kmarx-kmarx-kmarx/Fluidcs-Hardware-V2/User KiCad Library/user-3dmodels/raspberry-pi-pico-r3-1/RP2040 Microcontroller, Raspberry Pi Pico-R3, Top View.PNG

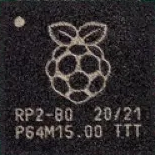
User KiCad Library/user-3dmodels/raspberry-pi-pico-r3-1/RP2040 Microcontroller, Raspberry Pi Pico-R3, Top View.PNG
