kmarx-kmarx-kmarx/Fluidcs-Hardware-V2/User KiCad Library/user-3dmodels/raspberry-pi-pico-r3-1/Raspberry Pi Pico-R3, Top View.PNG

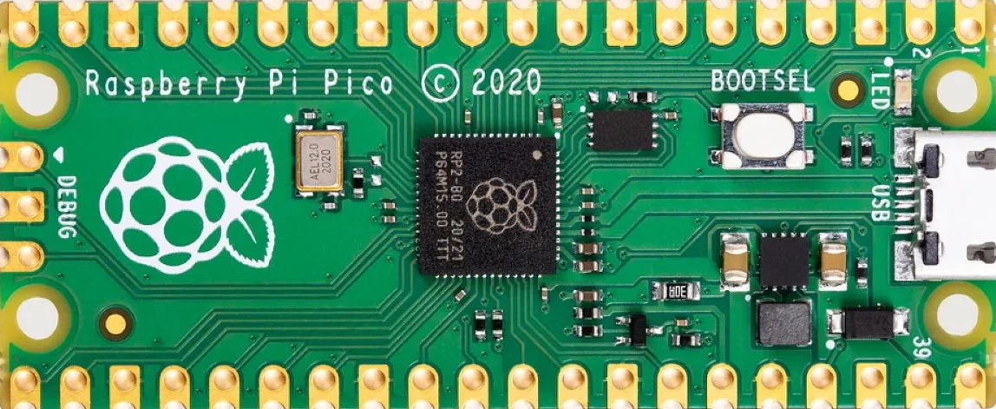
User KiCad Library/user-3dmodels/raspberry-pi-pico-r3-1/Raspberry Pi Pico-R3, Top View.PNG
