kmarx-kmarx-kmarx/Fluidcs-Hardware-V2/User KiCad Library/user-3dmodels/raspberry-pi-pico-r3-1/Raspberry Pi Pico-R3.JPG

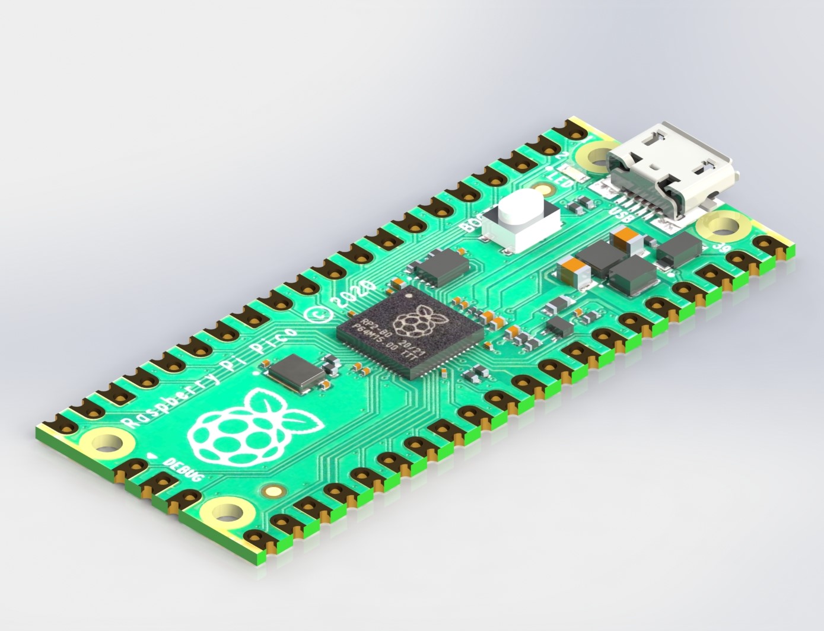
User KiCad Library/user-3dmodels/raspberry-pi-pico-r3-1/Raspberry Pi Pico-R3.JPG
