kmarx-kmarx-kmarx/Fluidcs-Hardware-V2/User KiCad Library/user-3dmodels/raspberry-pi-pico-r3-1/Raspberry Pi Pico-R3.SLDASM

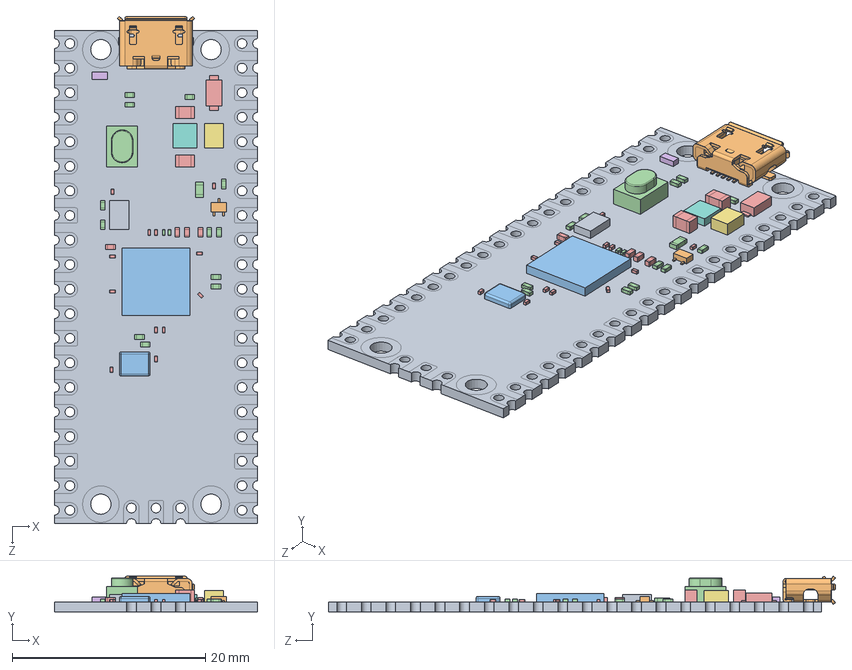
[picture p5: CAD file, 2023-08-08]
User KiCad Library/user-3dmodels/raspberry-pi-pico-r3-1/Raspberry Pi Pico-R3.SLDASM
21.0 x 3.69 x 52.4 mm
PCB, Raspberry Pi Pico-R3
MicroUSB Port, Raspberry Pi Pico-R3
RP2040 Microcontroller, Raspberry Pi Pico-R3
SW1, Tact Switch, Raspberry Pi Pico-R3
D1, Diode, Schottky, Raspberry Pi Pico-R3
D2, QSME-C194, LED, Raspberry Pi Pico-R3
L1, Inductor, Raspberry Pi Pico-R3
U2, RT6150B-33GQW, Buck Boost Converter, Raspberry Pi Pico-R3
U3, W25Q16JVUXIQ, Serial NOR Flash 16 Mbit, Raspberry Pi Pico-R3
Q1, MOSFET, DMG1012T, Raspberry Pi Pico-R3
X1, X12M000000S096, 12 Mhz Crystal Resonator, Raspberry Pi Pico-R3
SMD Resistor, Configurable, Raspberry Pi Pico-R3 x 15
SMD Capacitor, Configurable, Raspberry Pi Pico-R3 x 18
