kmarx-kmarx-kmarx/Fluidcs-Hardware-V2/User KiCad Library/user-3dmodels/Teensy_4.0_Assembly.STEP

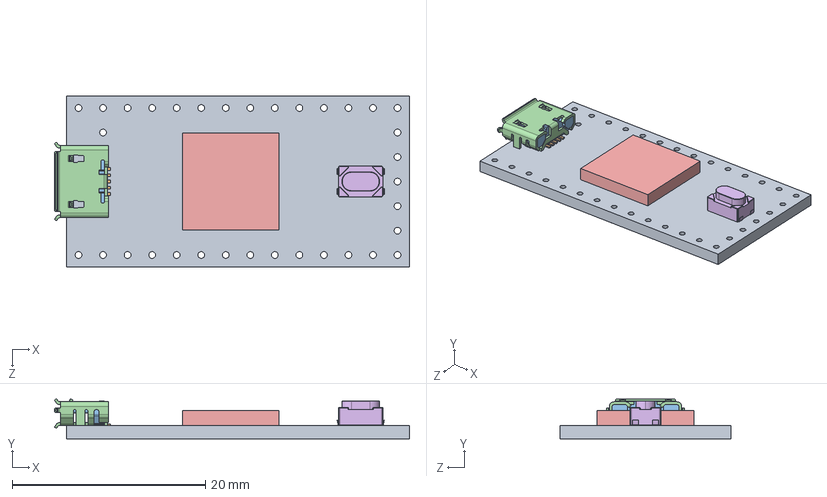
[picture p6: CAD file, 2023-08-08]
User KiCad Library/user-3dmodels/Teensy_4.0_Assembly.STEP
36.8 x 4.12 x 17.7 mm
Teensy_4.0_PCB
Micro USB-B Female 5Pin SMD
NXP iMXRT1062
SKRPACE010 v4
