kmarx-kmarx-kmarx/Fluidcs-Hardware-V2/User KiCad Library/user-3dmodels/B6B-ZR-SM4-TF.step

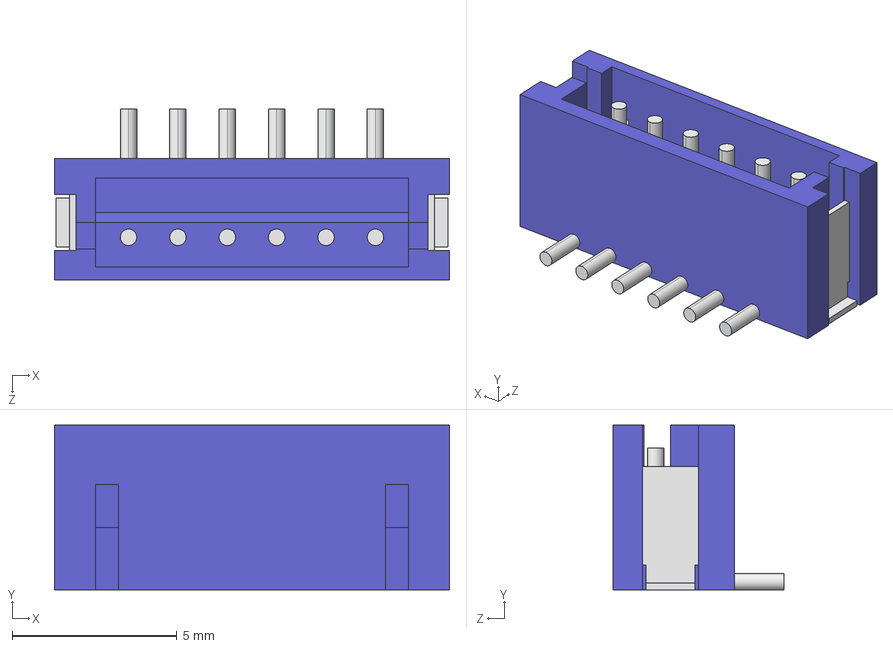
[picture p7: CAD file, 2023-08-08]
User KiCad Library/user-3dmodels/B6B-ZR-SM4-TF.step
12.0 x 5.00 x 5.20 mm
