kmarx-kmarx-kmarx/Fluidcs-Hardware-V2/User KiCad Library/user-3dmodels/raspberry-pi-pico-r3-1/RP2040 Microcontroller, Raspberry Pi Pico-R3.SLDPRT

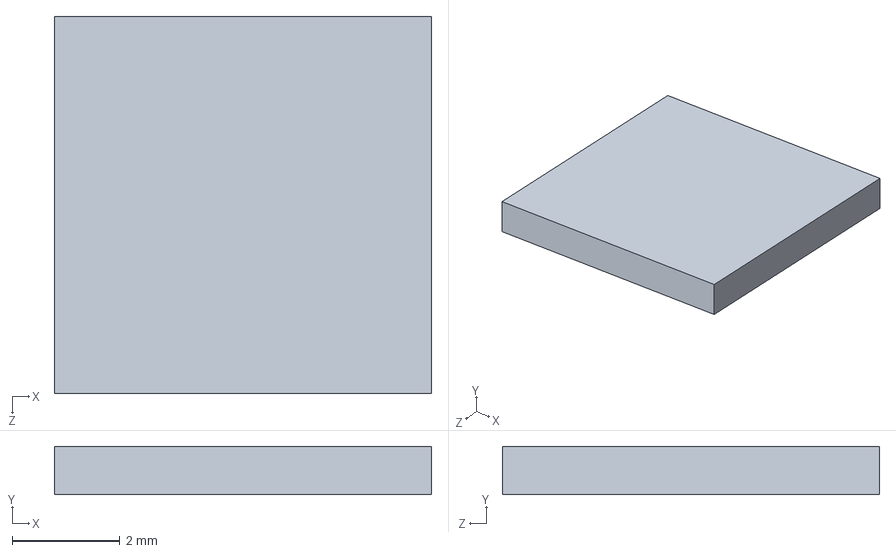
[picture p8: CAD file, 2023-08-08]
User KiCad Library/user-3dmodels/raspberry-pi-pico-r3-1/RP2040 Microcontroller, Raspberry Pi Pico-R3.SLDPRT
7.00 x 0.9 x 7.00 mm
