kmarx-kmarx-kmarx/Fluidcs-Hardware-V2/User KiCad Library/user-3dmodels/PTV09A-4020U-B103.stp

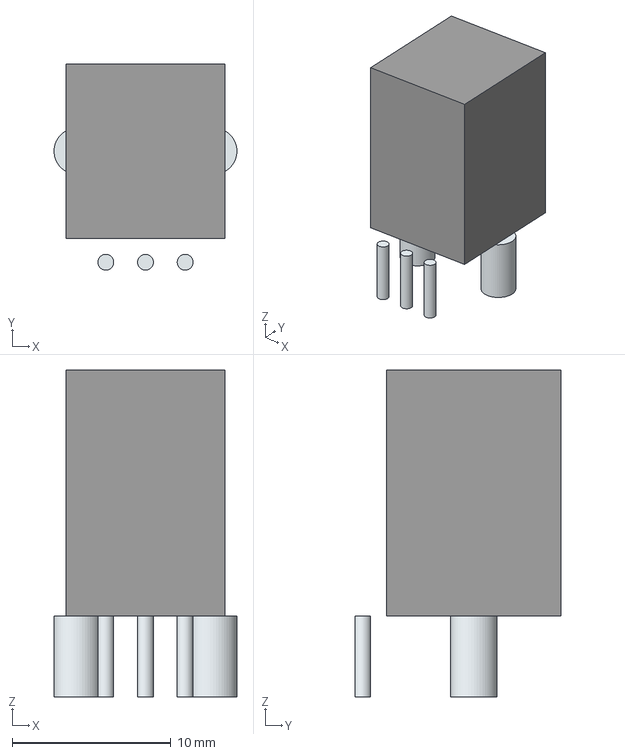
[picture p9: CAD file, 2023-08-08]
User KiCad Library/user-3dmodels/PTV09A-4020U-B103.stp
11.5 x 13.0 x 20.6 mm
Leads x 5
