kmarx-kmarx-kmarx/Fluidcs-Hardware-V2/User KiCad Library/user-3dmodels/raspberry-pi-pico-r3-1/SMD Capacitor, Configurable, Raspberry Pi Pico-R3.SLDPRT

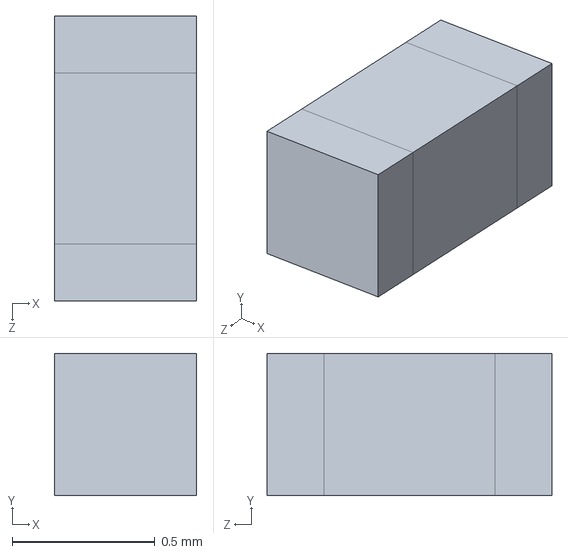
[picture p10: CAD file, 2023-08-08]
User KiCad Library/user-3dmodels/raspberry-pi-pico-r3-1/SMD Capacitor, Configurable, Raspberry Pi Pico-R3.SLDPRT
0.5 x 0.5 x 1.00 mm
