kmarx-kmarx-kmarx/Fluidcs-Hardware-V2/User KiCad Library/user-3dmodels/PCA9615DPJ.stp

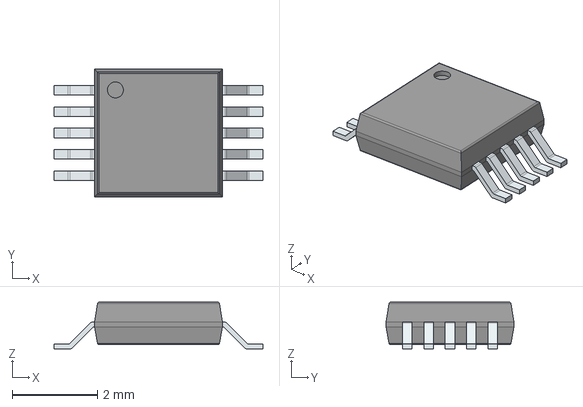
[picture p11: CAD file, 2023-08-08]
User KiCad Library/user-3dmodels/PCA9615DPJ.stp
4.90 x 3.00 x 1.10 mm
PinsArrayLR
