kmarx-kmarx-kmarx/Fluidcs-Hardware-V2/User KiCad Library/user-3dmodels/raspberry-pi-pico-r3-1/D1, Diode, Schottky, Raspberry Pi Pico-R3.SLDPRT

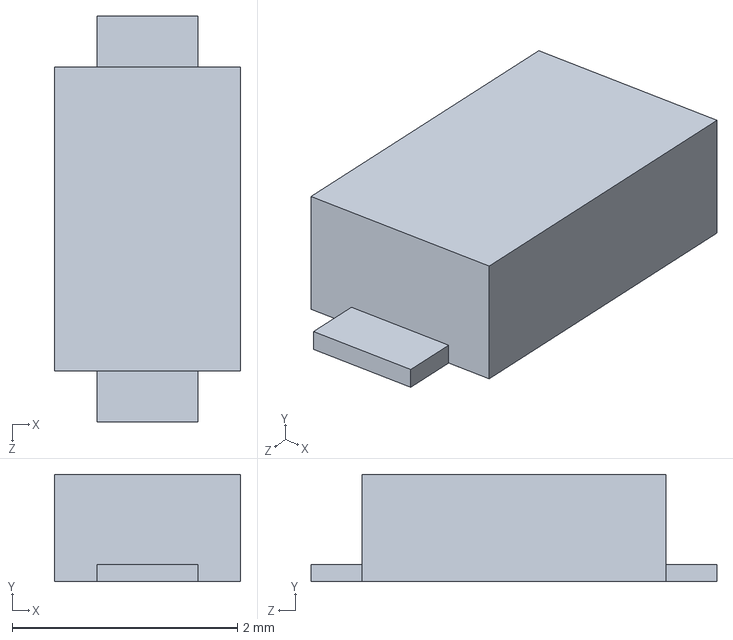
[picture p12: CAD file, 2023-08-08]
User KiCad Library/user-3dmodels/raspberry-pi-pico-r3-1/D1, Diode, Schottky, Raspberry Pi Pico-R3.SLDPRT
1.65 x 0.95 x 3.60 mm
