kmarx-kmarx-kmarx/Fluidcs-Hardware-V2/User KiCad Library/user-3dmodels/raspberry-pi-pico-r3-1/L1, Inductor, Raspberry Pi Pico-R3.SLDPRT

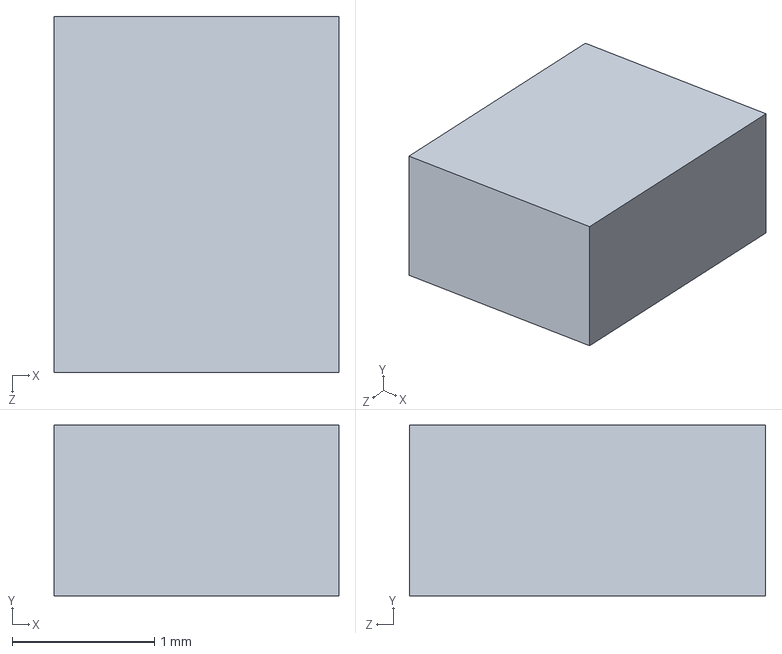
[picture p13: CAD file, 2023-08-08]
User KiCad Library/user-3dmodels/raspberry-pi-pico-r3-1/L1, Inductor, Raspberry Pi Pico-R3.SLDPRT
2.00 x 1.20 x 2.50 mm
