kmarx-kmarx-kmarx/Fluidcs-Hardware-V2/User KiCad Library/user-3dmodels/B4B-ZR-SM4-TFT_LF__SN_.step

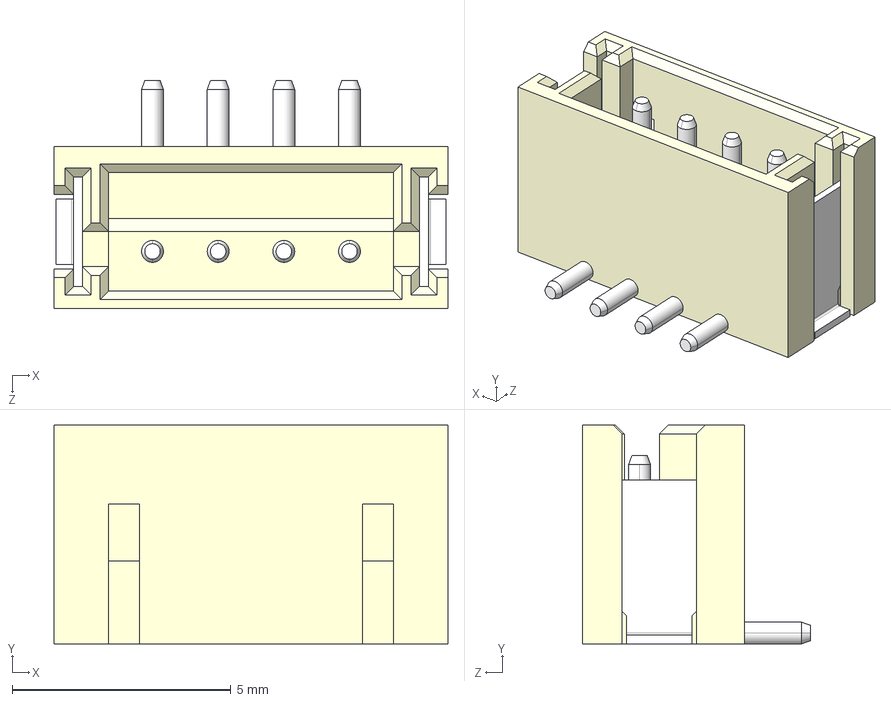
[picture p14: CAD file, 2023-08-08]
User KiCad Library/user-3dmodels/B4B-ZR-SM4-TFT_LF__SN_.step
9.00 x 5.00 x 5.20 mm
