kmarx-kmarx-kmarx/Fluidcs-Hardware-V2/User KiCad Library/user-3dmodels/raspberry-pi-pico-r3-1/MicroUSB Port, Raspberry Pi Pico-R3.SLDPRT

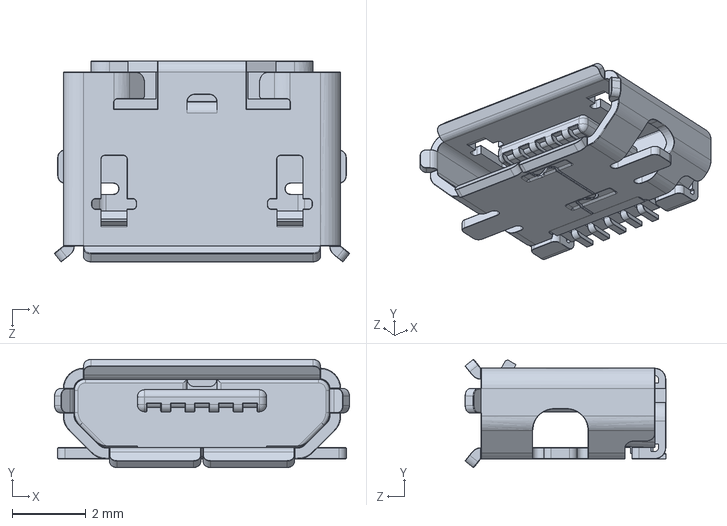
[picture p15: CAD file, 2023-08-08]
User KiCad Library/user-3dmodels/raspberry-pi-pico-r3-1/MicroUSB Port, Raspberry Pi Pico-R3.SLDPRT
7.97 x 2.92 x 5.43 mm
