kmarx-kmarx-kmarx/Fluidcs-Hardware-V2/User KiCad Library/user-3dmodels/raspberry-pi-pico-r3-1/PCB, Raspberry Pi Pico-R3.SLDPRT

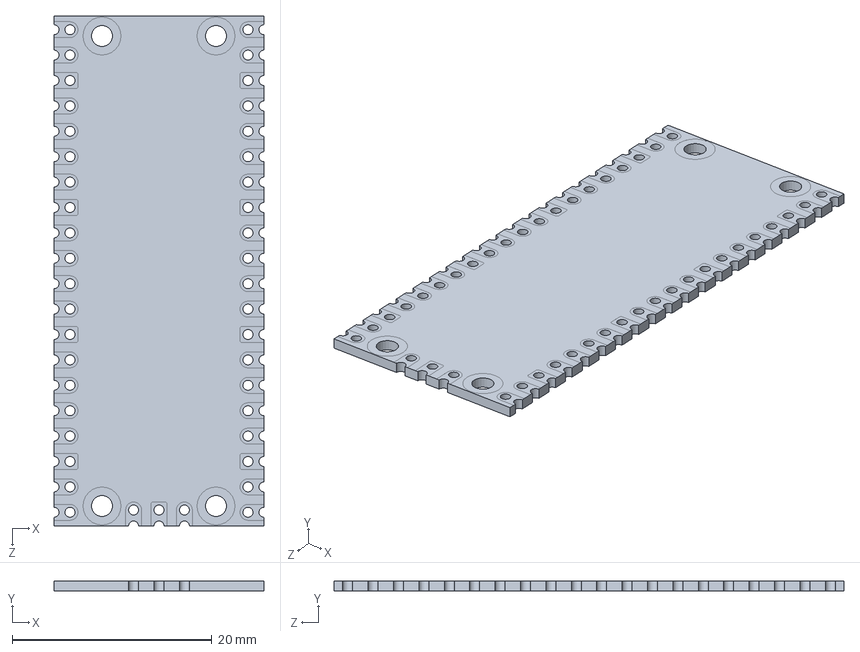
[picture p16: CAD file, 2023-08-08]
User KiCad Library/user-3dmodels/raspberry-pi-pico-r3-1/PCB, Raspberry Pi Pico-R3.SLDPRT
21.0 x 1.00 x 51.0 mm
