kmarx-kmarx-kmarx/Fluidcs-Hardware-V2/User KiCad Library/user-3dmodels/raspberry-pi-pico-r3-1/D2, QSME-C194, LED, Raspberry Pi Pico-R3.SLDPRT

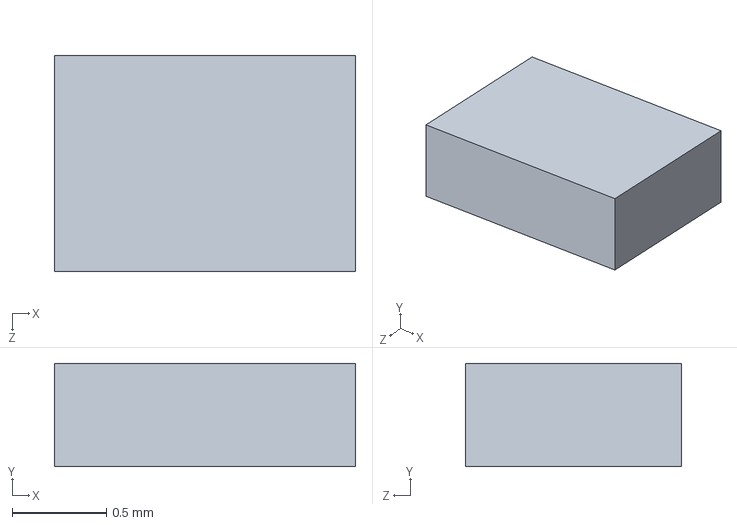
[picture p18: CAD file, 2023-08-08]
User KiCad Library/user-3dmodels/raspberry-pi-pico-r3-1/D2, QSME-C194, LED, Raspberry Pi Pico-R3.SLDPRT
1.60 x 0.55 x 1.15 mm
