kmarx-kmarx-kmarx/Fluidcs-Hardware-V2/User KiCad Library/user-3dmodels/raspberry-pi-pico-r3-1/X1, X12M000000S096, 12 Mhz Crystal Resonator, Raspberry Pi Pico-R3.SLDPRT

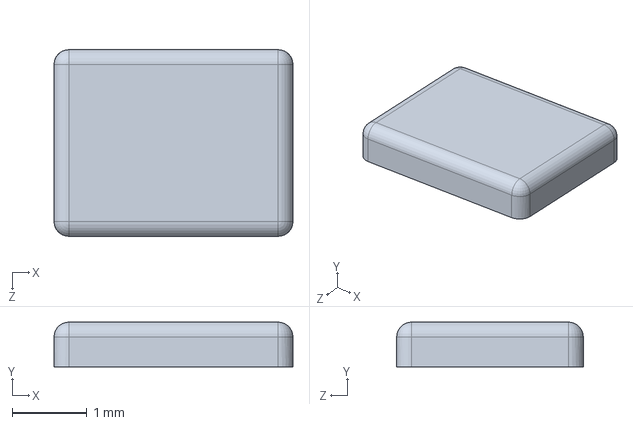
[picture p19: CAD file, 2023-08-08]
User KiCad Library/user-3dmodels/raspberry-pi-pico-r3-1/X1, X12M000000S096, 12 Mhz Crystal Resonator, Raspberry Pi Pico-R3.SLDPRT
3.20 x 0.6 x 2.50 mm
