kmarx-kmarx-kmarx/Fluidcs-Hardware-V2/User KiCad Library/user-3dmodels/A1120ELHLT-T.step

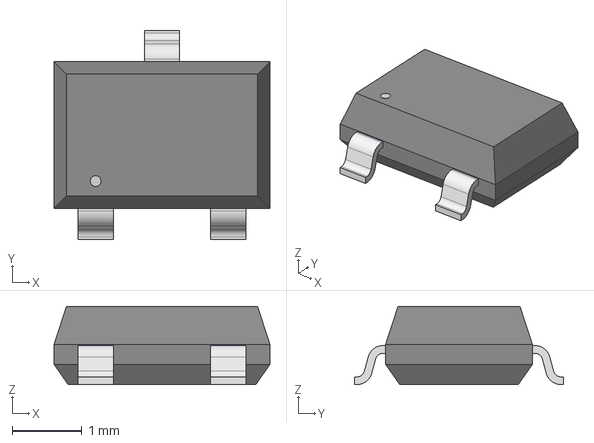
[picture p20: CAD file, 2023-08-08]
User KiCad Library/user-3dmodels/A1120ELHLT-T.step
3.10 x 3.00 x 1.12 mm
