kmarx-kmarx-kmarx/Fluidcs-Hardware-V2/User KiCad Library/user-3dmodels/raspberry-pi-pico-r3-1/U2, RT6150B-33GQW, Buck Boost Converter, Raspberry Pi Pico-R3.SLDPRT

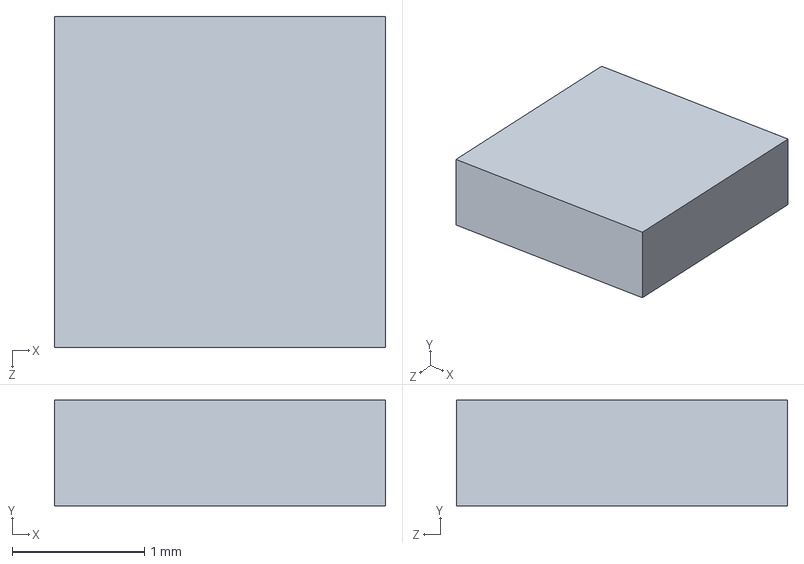
[picture p21: CAD file, 2023-08-08]
User KiCad Library/user-3dmodels/raspberry-pi-pico-r3-1/U2, RT6150B-33GQW, Buck Boost Converter, Raspberry Pi Pico-R3.SLDPRT
2.50 x 0.8 x 2.50 mm
