kmarx-kmarx-kmarx/Fluidcs-Hardware-V2/User KiCad Library/user-3dmodels/u3v12fx.step

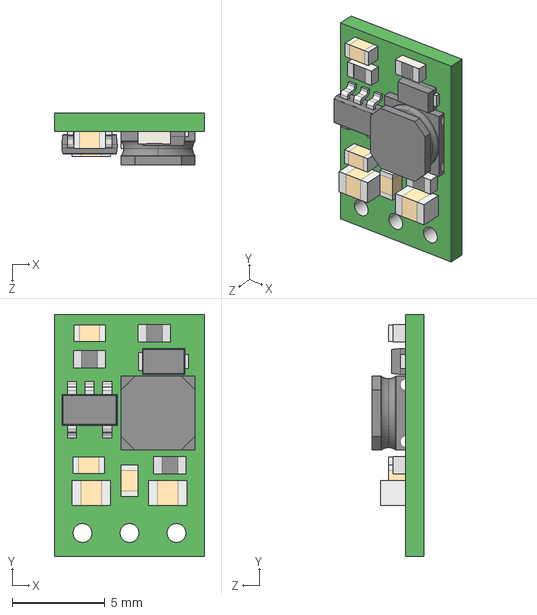
[picture p22: CAD file, 2023-08-08]
User KiCad Library/user-3dmodels/u3v12fx.step
8.13 x 13.1 x 2.82 mm
