kmarx-kmarx-kmarx/Fluidcs-Hardware-V2/User KiCad Library/user-3dmodels/LTC4312IMS#PBF.stp

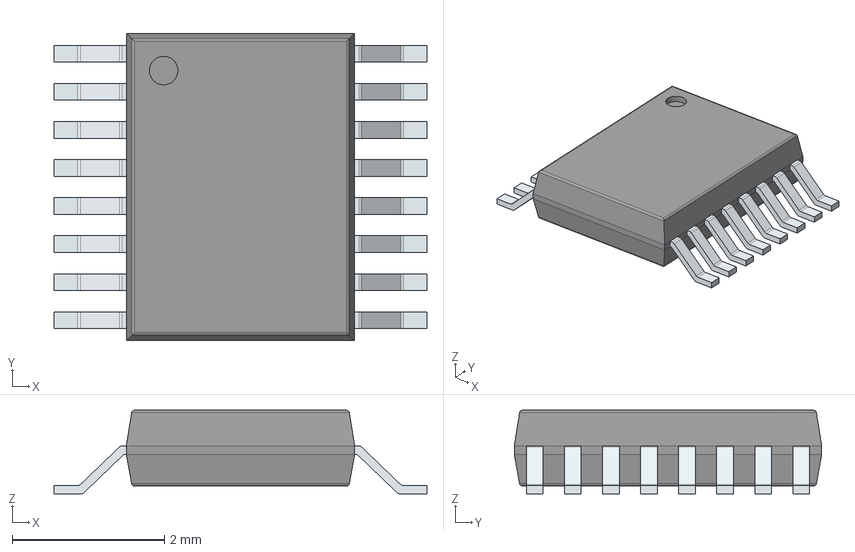
[picture p23: CAD file, 2023-08-08]
User KiCad Library/user-3dmodels/LTC4312IMS#PBF.stp
4.90 x 4.04 x 1.10 mm
PinsArrayLR
