kmarx-kmarx-kmarx/Fluidcs-Hardware-V2/User KiCad Library/user-3dmodels/raspberry-pi-pico-r3-1/Q1, MOSFET, DMG1012T, Raspberry Pi Pico-R3.SLDPRT

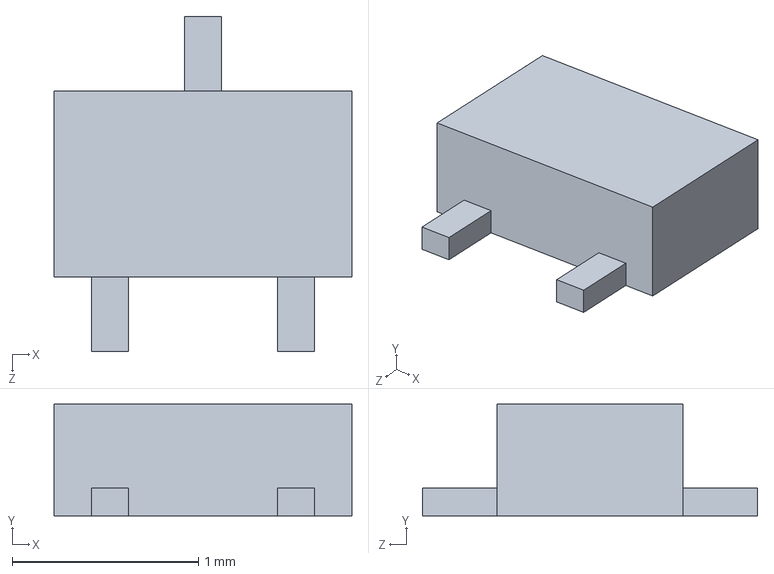
[picture p24: CAD file, 2023-08-08]
User KiCad Library/user-3dmodels/raspberry-pi-pico-r3-1/Q1, MOSFET, DMG1012T, Raspberry Pi Pico-R3.SLDPRT
1.60 x 0.6 x 1.80 mm
