kmarx-kmarx-kmarx/Fluidcs-Hardware-V2/User KiCad Library/user-3dmodels/CUI_DEVICES_PJ-036AH-SMT-TR.step

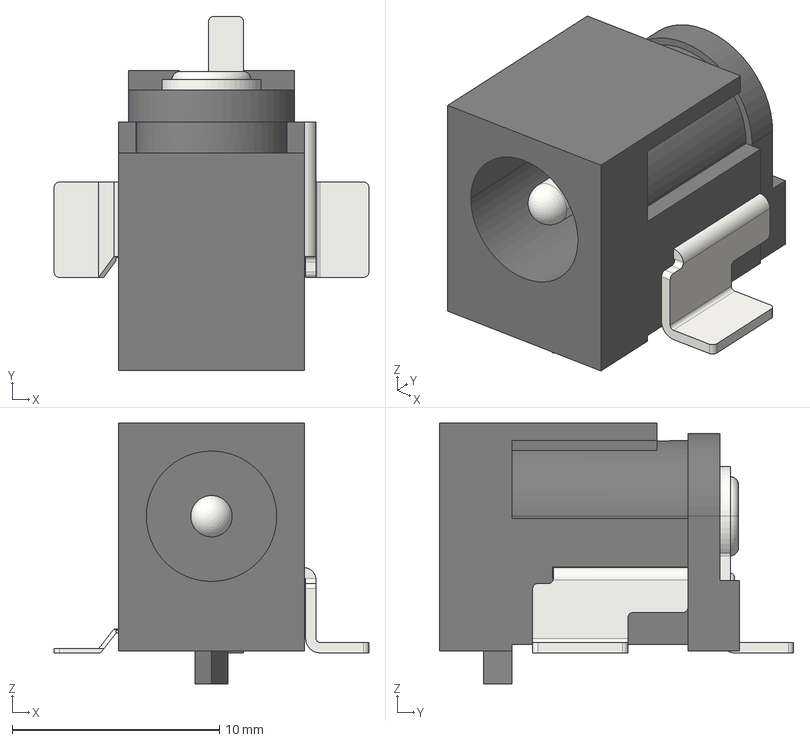
[picture p25: CAD file, 2023-08-08]
User KiCad Library/user-3dmodels/CUI_DEVICES_PJ-036AH-SMT-TR.step
15.2 x 17.1 x 12.6 mm
