kmarx-kmarx-kmarx/Fluidcs-Hardware-V2/User KiCad Library/user-3dmodels/raspberry-pi-pico-r3-1/SW1, Tact Switch, Raspberry Pi Pico-R3.SLDPRT

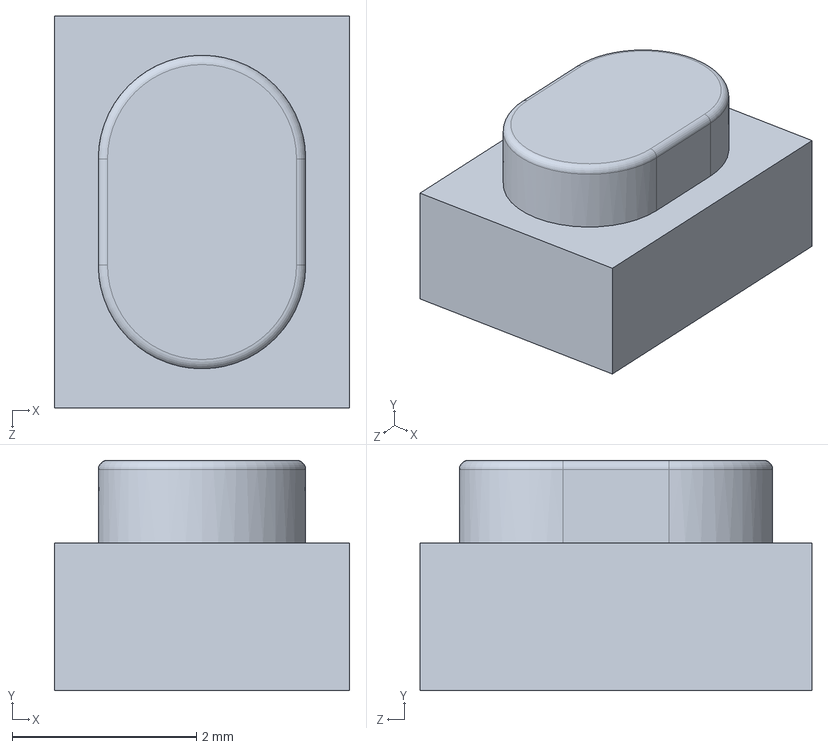
[picture p26: CAD file, 2023-08-08]
User KiCad Library/user-3dmodels/raspberry-pi-pico-r3-1/SW1, Tact Switch, Raspberry Pi Pico-R3.SLDPRT
3.20 x 2.50 x 4.25 mm
