kmarx-kmarx-kmarx/Fluidcs-Hardware-V2/User KiCad Library/user-3dmodels/B3B-PH-SM4-TB_LF__SN_.step

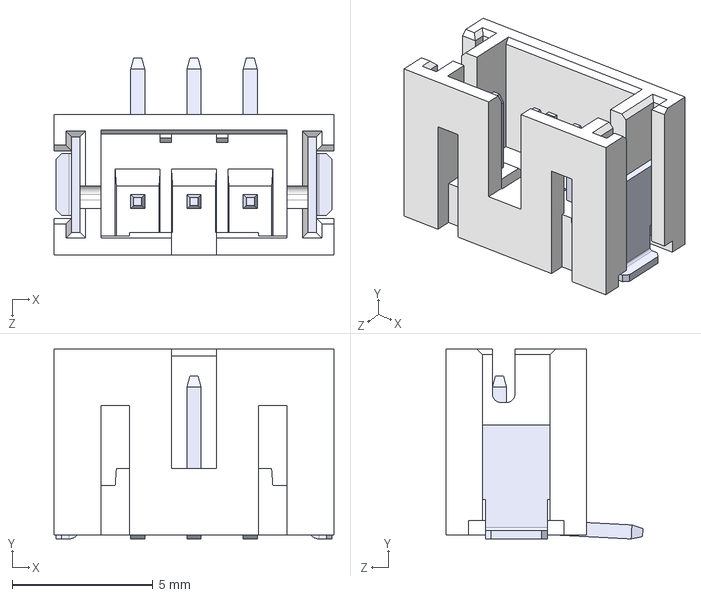
[picture p27: CAD file, 2023-08-08]
User KiCad Library/user-3dmodels/B3B-PH-SM4-TB_LF__SN_.step
9.95 x 6.75 x 7.00 mm
