kmarx-kmarx-kmarx/Fluidcs-Hardware-V2/User KiCad Library/user-3dmodels/ASI301TRQ_MAL.step

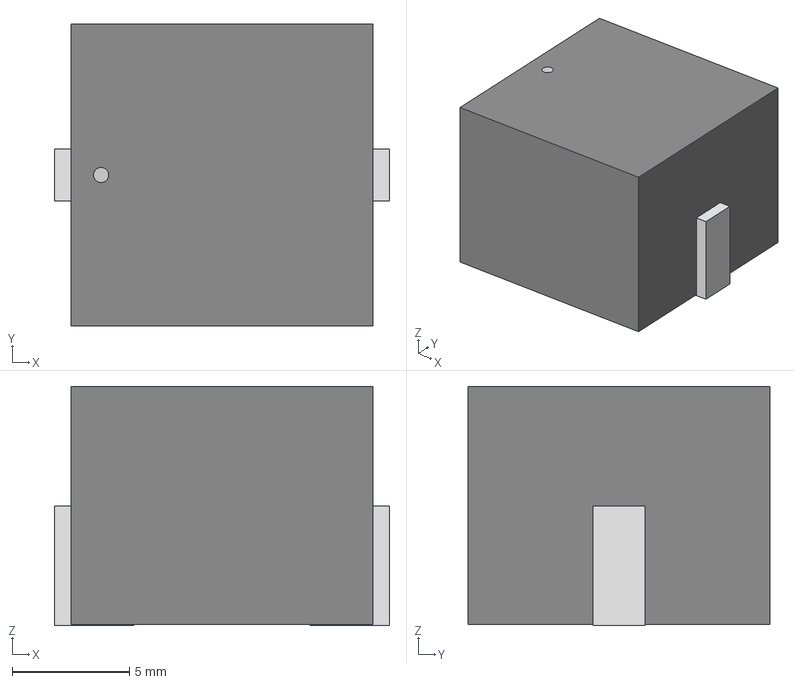
[picture p28: CAD file, 2023-08-08]
User KiCad Library/user-3dmodels/ASI301TRQ_MAL.step
14.3 x 12.9 x 10.2 mm
