kmarx-kmarx-kmarx/Fluidcs-Hardware-V2/User KiCad Library/user-3dmodels/R-0904N-L-20KQ.step

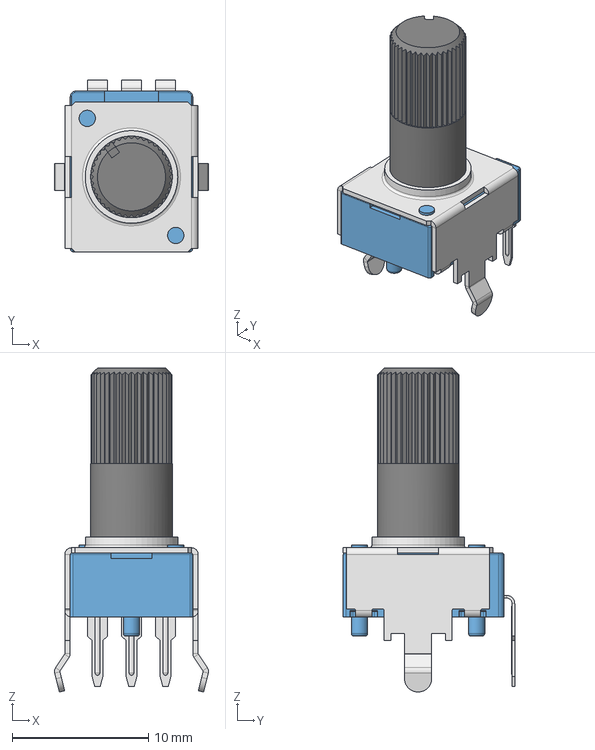
[picture p29: CAD file, 2023-08-08]
User KiCad Library/user-3dmodels/R-0904N-L-20KQ.step
11.3 x 12.6 x 23.8 mm
