kmarx-kmarx-kmarx/Fluidcs-Hardware-V2/User KiCad Library/user-3dmodels/MSS5Mxx.stp

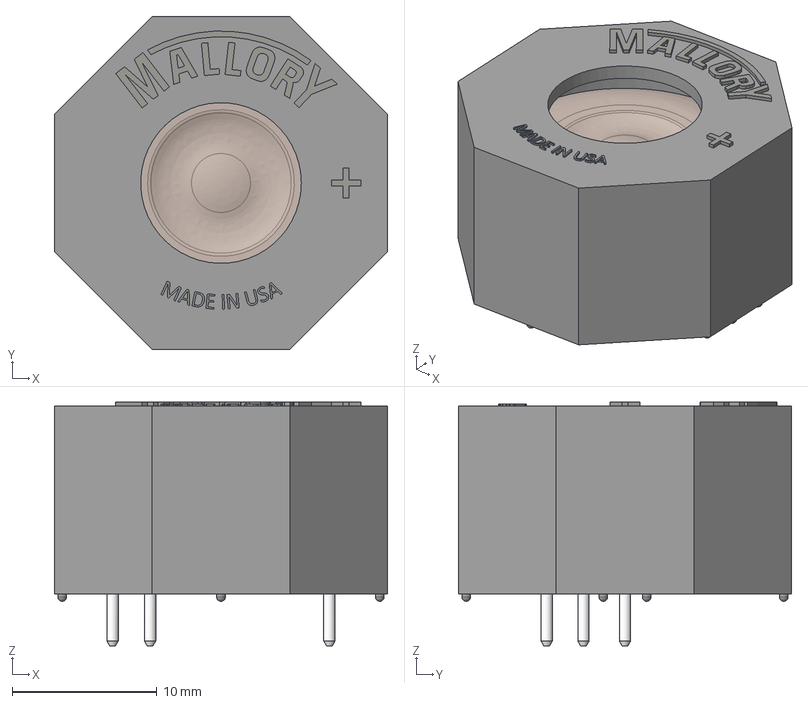
[picture p30: CAD file, 2023-08-08]
User KiCad Library/user-3dmodels/MSS5Mxx.stp
23.0 x 23.0 x 16.8 mm
PCB80-10
42-05090 (Soldered) x 4
SPK1-01
LAB5-01
