kmarx-kmarx-kmarx/Fluidcs-Hardware-V2/User KiCad Library/user-3dmodels/ADUM1250WSRZ-RL7.stp

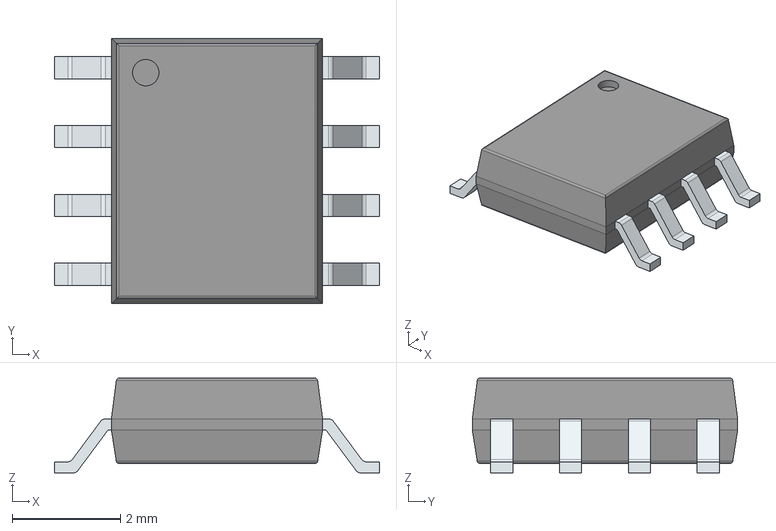
[picture p31: CAD file, 2023-08-08]
User KiCad Library/user-3dmodels/ADUM1250WSRZ-RL7.stp
6.00 x 4.90 x 1.75 mm
PinsArrayLR
