kmarx-kmarx-kmarx/Fluidcs-Hardware-V2/User KiCad Library/user-3dmodels/CUI_PDS2-S5-S12-M.step

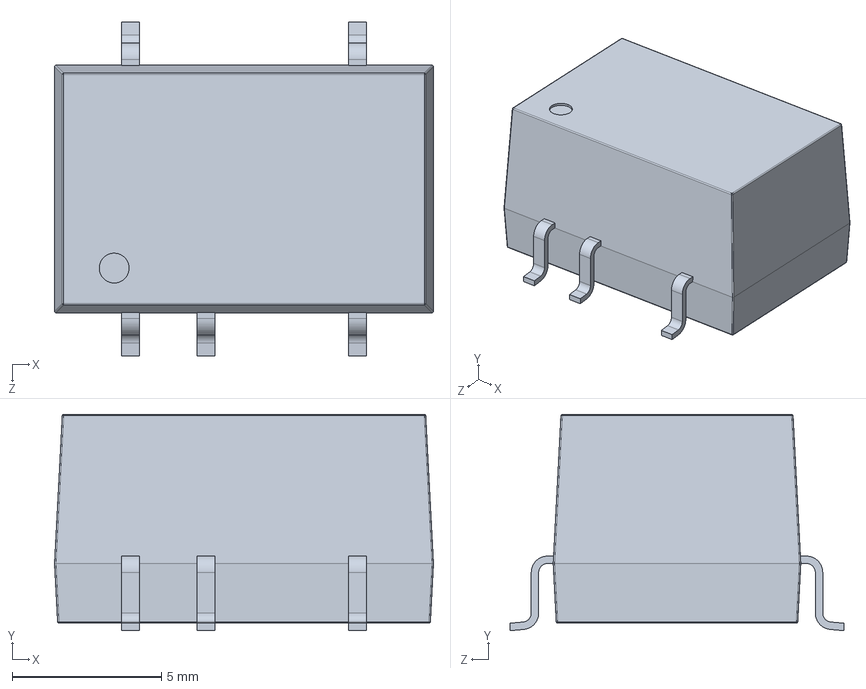
[picture p32: CAD file, 2023-08-08]
User KiCad Library/user-3dmodels/CUI_PDS2-S5-S12-M.step
12.7 x 7.25 x 11.2 mm
