kmarx-kmarx-kmarx/Fluidcs-Hardware-V2/User KiCad Library/user-3dmodels/SM9541-100C-D-C-3-S.stp

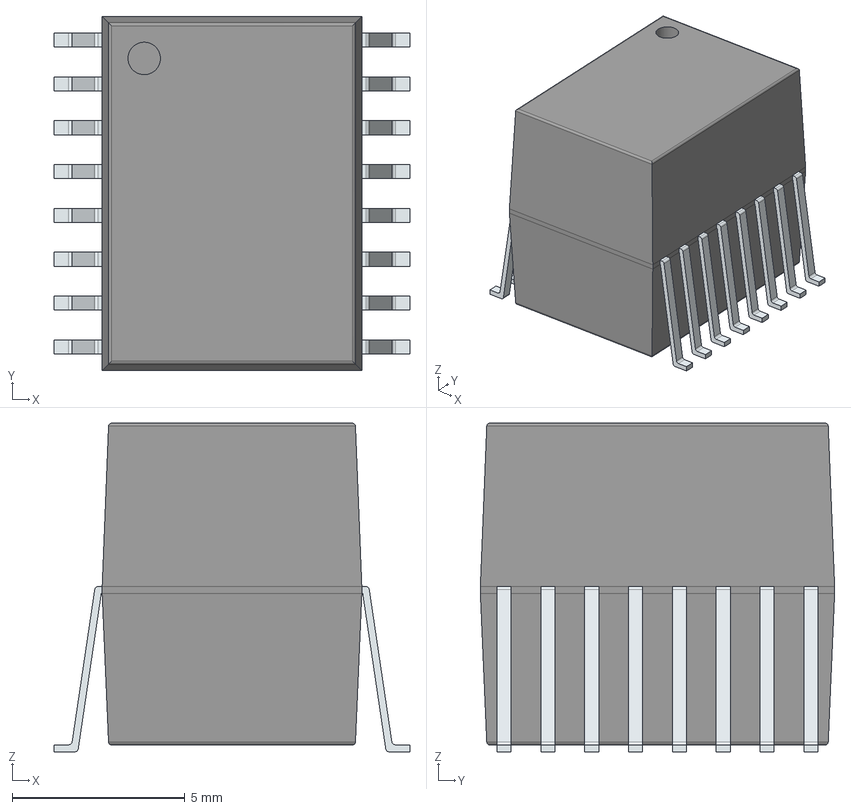
[picture p33: CAD file, 2023-08-08]
User KiCad Library/user-3dmodels/SM9541-100C-D-C-3-S.stp
10.3 x 10.3 x 9.52 mm
PinsArrayLR
