kmarx-kmarx-kmarx/Fluidcs-Hardware-V2/User KiCad Library/user-3dmodels/LTC4311.stp

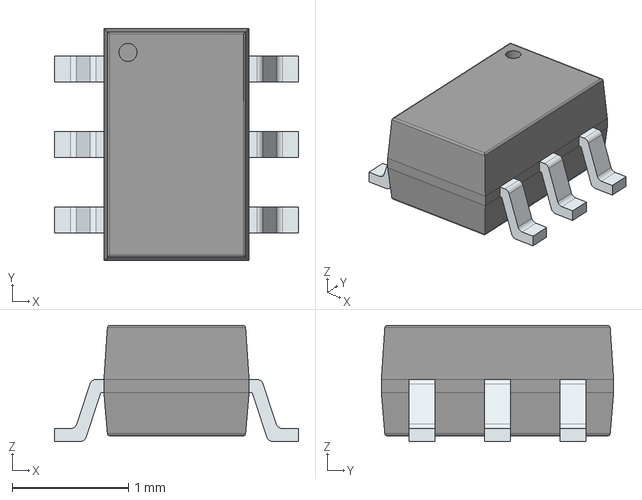
[picture p34: CAD file, 2023-08-08]
User KiCad Library/user-3dmodels/LTC4311.stp
2.10 x 2.00 x 1.00 mm
PinsArrayLR
