kmarx-kmarx-kmarx/Fluidcs-Hardware-V2/User KiCad Library/user-3dmodels/AH1806-W-7.stp

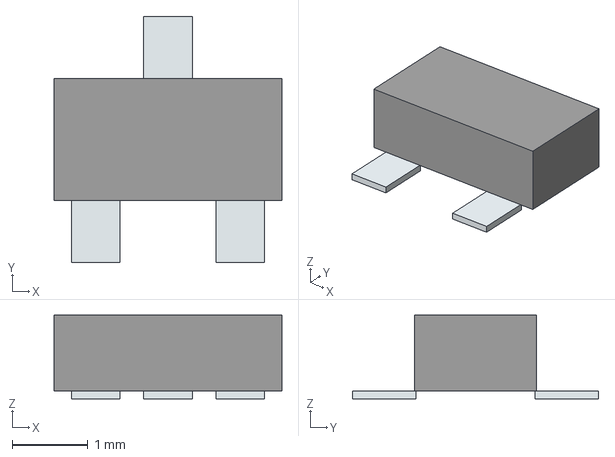
[picture p35: CAD file, 2023-08-08]
User KiCad Library/user-3dmodels/AH1806-W-7.stp
3.00 x 3.24 x 1.10 mm
Pins
