kmarx-kmarx-kmarx/Fluidcs-Hardware-V2/User KiCad Library/user-3dmodels/c-4515do-ds3bk004dp-d-3d.stp

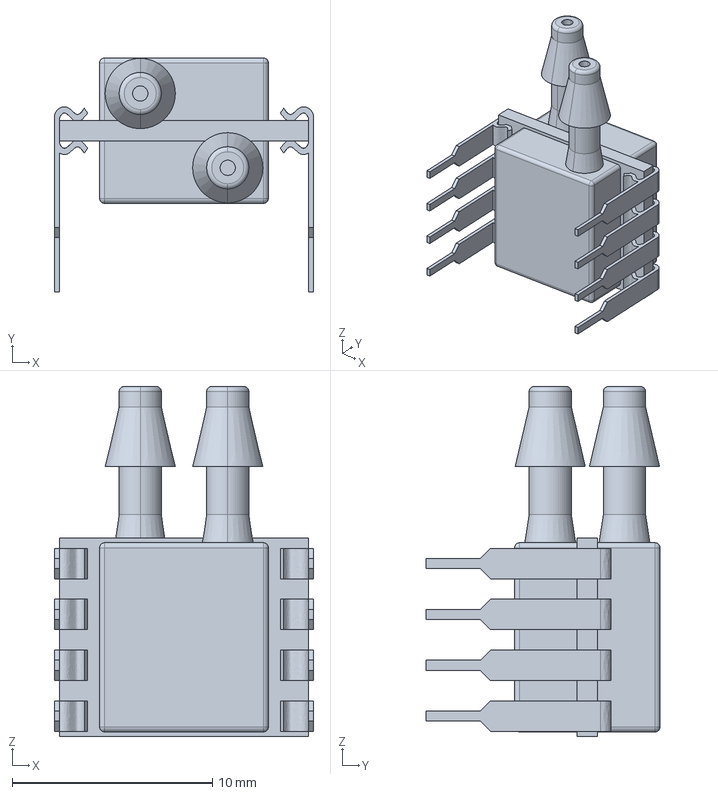
[picture p36: CAD file, 2023-08-08]
User KiCad Library/user-3dmodels/c-4515do-ds3bk004dp-d-3d.stp
13.0 x 11.7 x 17.5 mm
