kmarx-kmarx-kmarx/Fluidcs-Hardware-V2/User KiCad Library/user-3dmodels/trustability-smt-rr-cad-model.stp

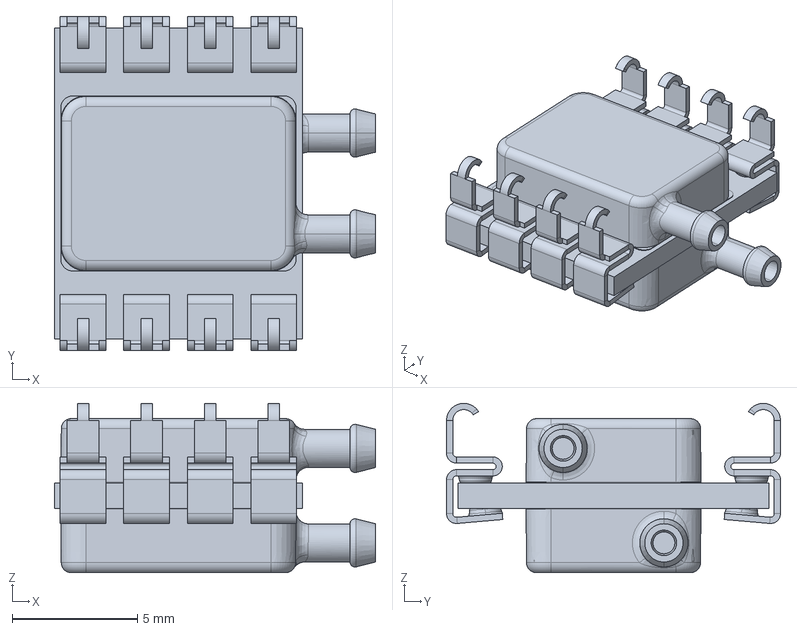
[picture p37: CAD file, 2023-08-08]
User KiCad Library/user-3dmodels/trustability-smt-rr-cad-model.stp
12.8 x 13.3 x 6.77 mm
