kmarx-kmarx-kmarx/Fluidcs-Hardware-V2/User KiCad Library/user-3dmodels/S6B-ZR-SM4A-TF_LF__SN_.step

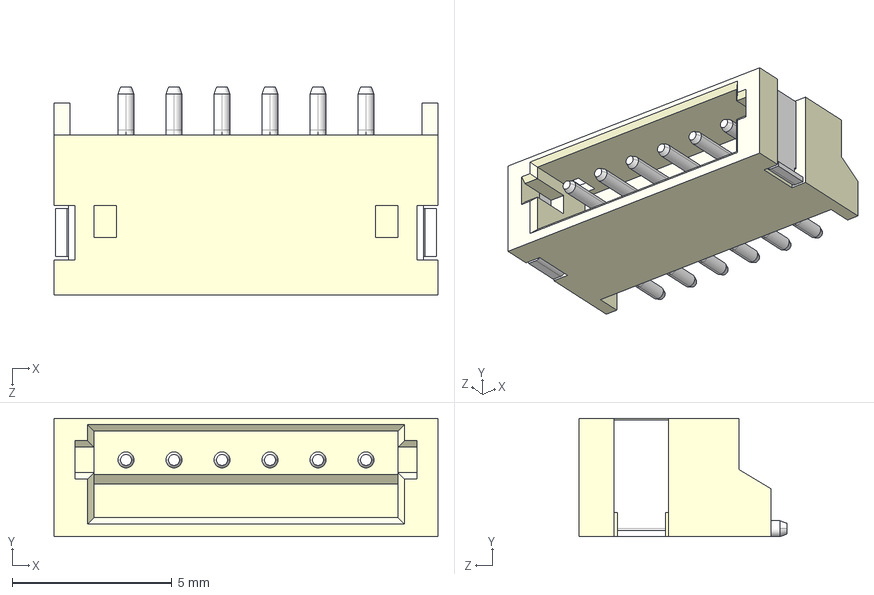
[picture p38: CAD file, 2023-08-08]
User KiCad Library/user-3dmodels/S6B-ZR-SM4A-TF_LF__SN_.step
12.0 x 3.70 x 6.50 mm
