kmarx-kmarx-kmarx/Fluidcs-Hardware-V2/User KiCad Library/user-3dmodels/R-0904N-L-15KQ-black.step

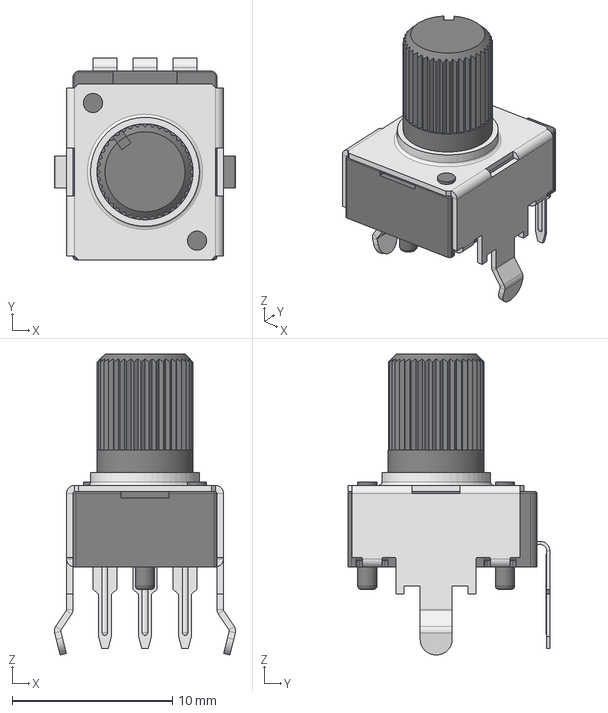
[picture p39: CAD file, 2023-08-08]
User KiCad Library/user-3dmodels/R-0904N-L-15KQ-black.step
11.3 x 12.6 x 18.8 mm
