kmarx-kmarx-kmarx/Fluidcs-Hardware-V2/User KiCad Library/user-3dmodels/SM03B-SURS-TF_LF__SN_.stp

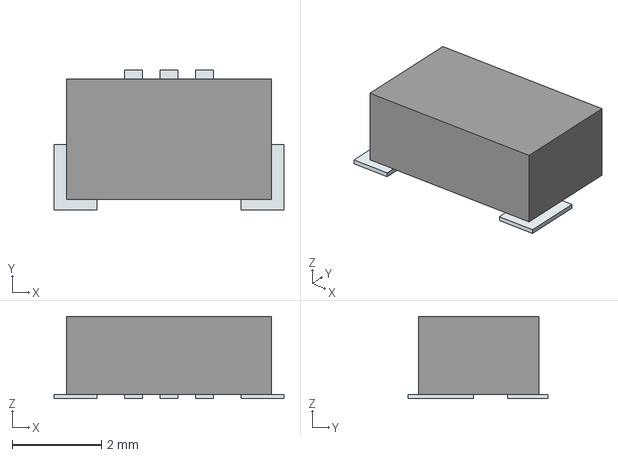
[picture p41: CAD file, 2023-08-08]
User KiCad Library/user-3dmodels/SM03B-SURS-TF_LF__SN_.stp
5.16 x 3.13 x 1.85 mm
Pins
