kmarx-kmarx-kmarx/Fluidcs-Hardware-V2/User KiCad Library/user-3dmodels/GPTS203211B.step

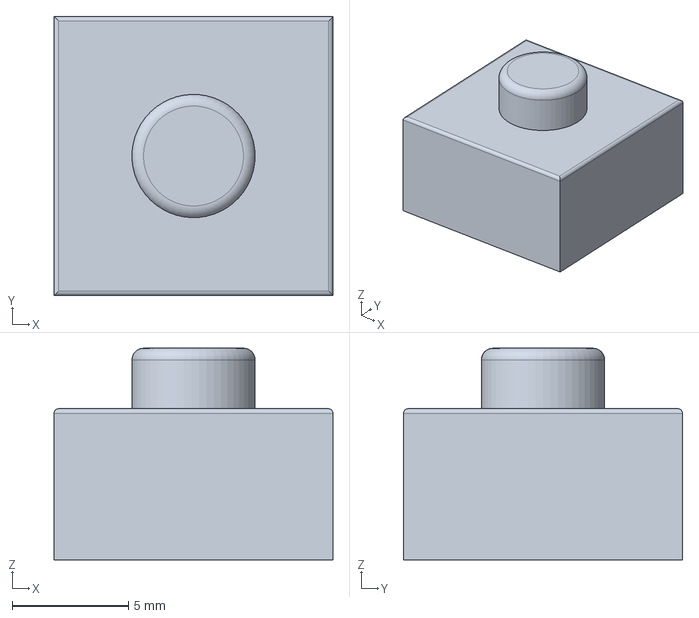
[picture p42: CAD file, 2023-08-08]
User KiCad Library/user-3dmodels/GPTS203211B.step
12.0 x 12.0 x 9.10 mm
