kmarx-kmarx-kmarx/Fluidcs-Hardware-V2/User KiCad Library/user-3dmodels/TTP Ventus - Disc Pump - BL-XP-LT Series model.STEP

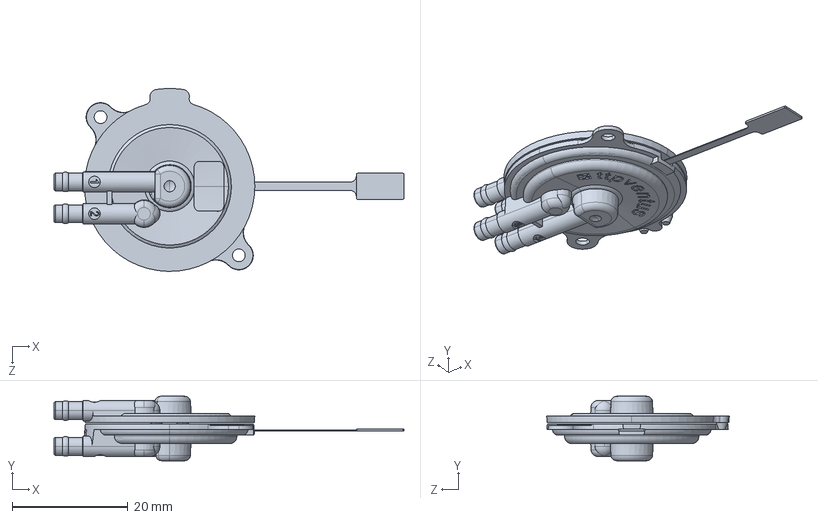
[picture p43: CAD file, 2023-08-08]
User KiCad Library/user-3dmodels/TTP Ventus - Disc Pump - BL-XP-LT Series model.STEP
60.5 x 11.2 x 31.6 mm
