kmarx-kmarx-kmarx/Fluidcs-Hardware-V2/User KiCad Library/user-3dmodels/DRV103U.stp

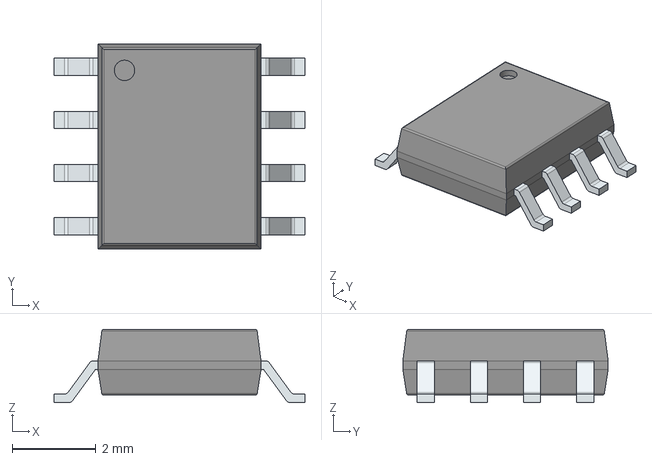
[picture p44: CAD file, 2023-08-08]
User KiCad Library/user-3dmodels/DRV103U.stp
6.00 x 4.91 x 1.75 mm
PinsArrayLR
