kmarx-kmarx-kmarx/Fluidcs-Hardware-V2/User KiCad Library/user-3dmodels/TPL7407LAPWR.stp

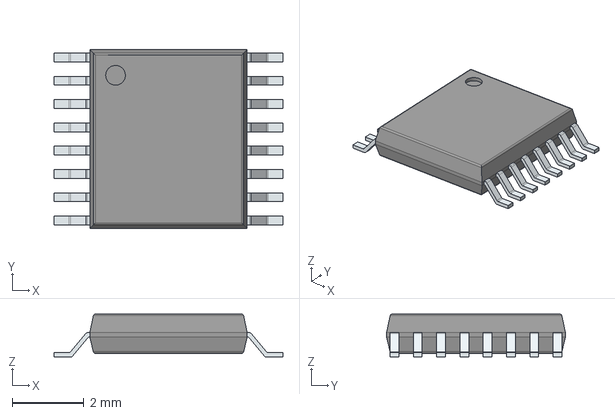
[picture p45: CAD file, 2023-08-08]
User KiCad Library/user-3dmodels/TPL7407LAPWR.stp
6.40 x 5.00 x 1.20 mm
PinsArrayLR
