kmarx-kmarx-kmarx/Fluidcs-Hardware-V2/User KiCad Library/user-3dmodels/SM03B-SURS-TF.STEP

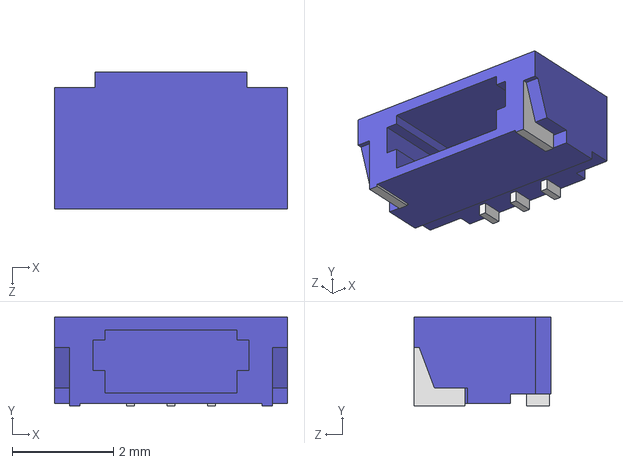
[picture p46: CAD file, 2023-08-08]
User KiCad Library/user-3dmodels/SM03B-SURS-TF.STEP
4.60 x 1.75 x 2.70 mm
