kmarx-kmarx-kmarx/Fluidcs-Hardware-V2/User KiCad Library/user-3dmodels/BM04B-SRSS-TBT_LF__SN_.step

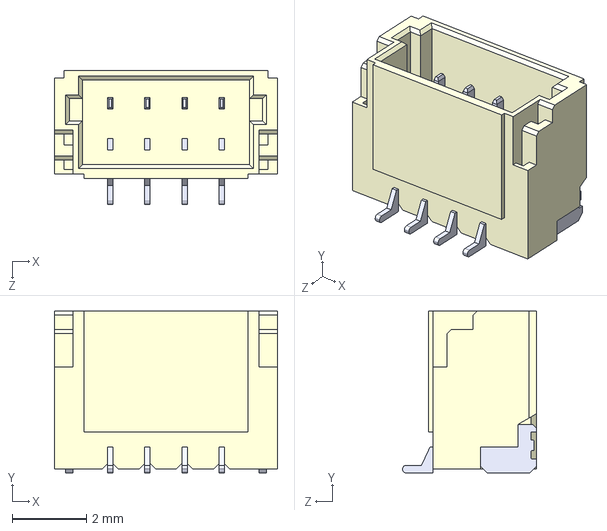
[picture p47: CAD file, 2023-08-08]
User KiCad Library/user-3dmodels/BM04B-SRSS-TBT_LF__SN_.step
6.00 x 4.35 x 3.60 mm
