kmarx-kmarx-kmarx/Fluidcs-Hardware-V2/User KiCad Library/user-3dmodels/SM10B-SRSS-TB.STEP

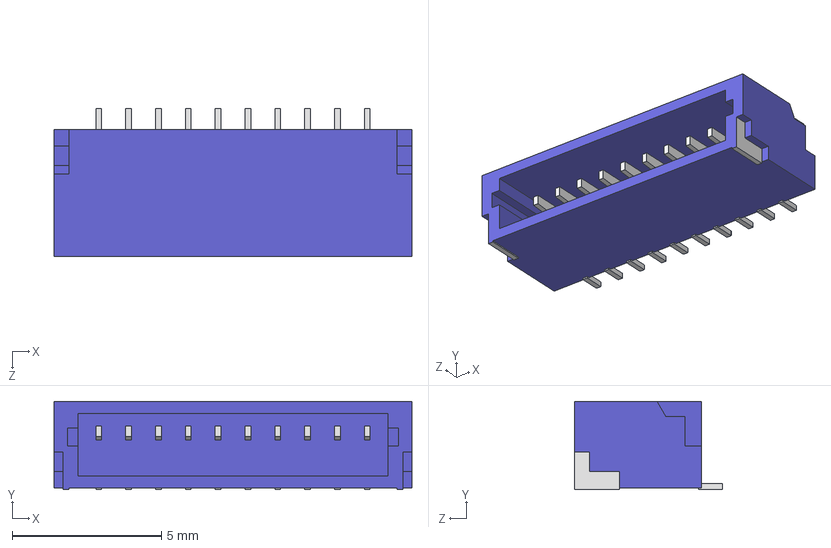
[picture p48: CAD file, 2023-08-08]
User KiCad Library/user-3dmodels/SM10B-SRSS-TB.STEP
12.0 x 2.96 x 4.95 mm
