kmarx-kmarx-kmarx/Fluidcs-Hardware-V2/User KiCad Library/user-3dmodels/pj-037ah-smt-tr.stp

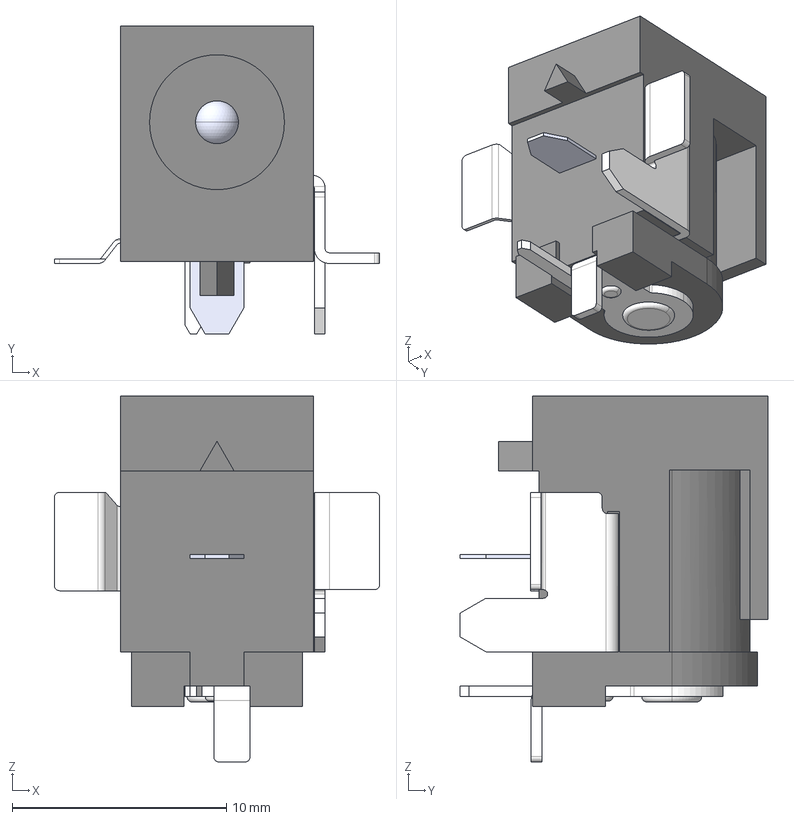
[picture p49: CAD file, 2023-08-08]
User KiCad Library/user-3dmodels/pj-037ah-smt-tr.stp
15.2 x 14.4 x 17.1 mm
