kmarx-kmarx-kmarx/Fluidcs-Hardware-V2/User KiCad Library/user-3dmodels/STTH102AY.stp

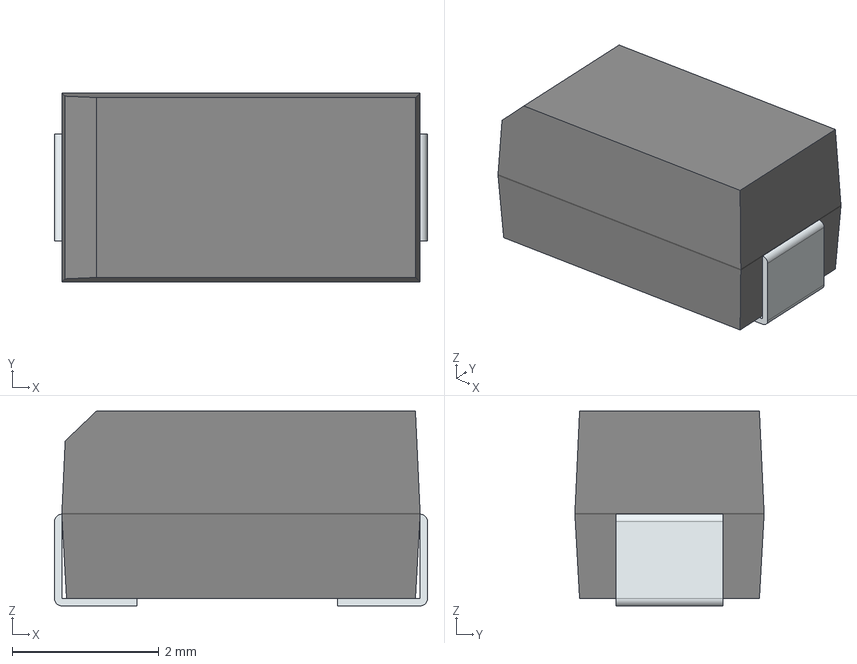
[picture p50: CAD file, 2023-08-08]
User KiCad Library/user-3dmodels/STTH102AY.stp
5.08 x 2.58 x 2.65 mm
FilletPin1
FilletPin2
