kmarx-kmarx-kmarx/Fluidcs-Hardware-V2/User KiCad Library/user-3dmodels/pololu-1a-step-down-voltage-regulator-d24v10fx.step

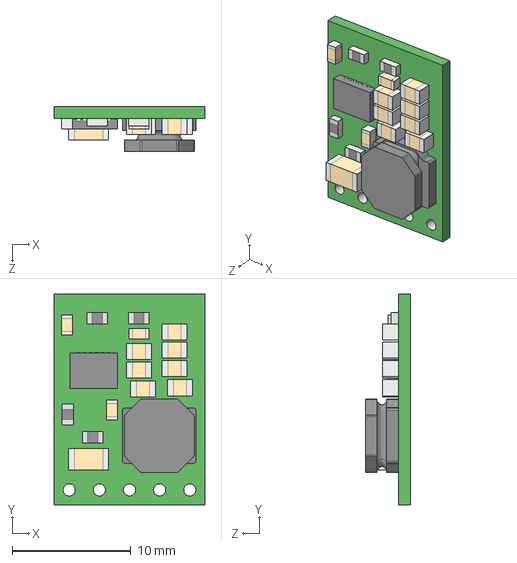
[picture p51: CAD file, 2023-08-08]
User KiCad Library/user-3dmodels/pololu-1a-step-down-voltage-regulator-d24v10fx.step
12.7 x 17.8 x 3.82 mm
