kmarx-kmarx-kmarx/Fluidcs-Hardware-V2/User KiCad Library/user-3dmodels/BM05B-SRSS-TB_LF__SN_.step

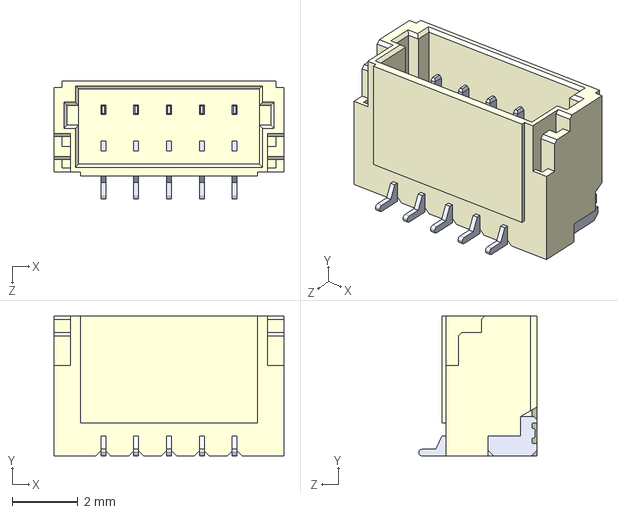
[picture p52: CAD file, 2023-08-08]
User KiCad Library/user-3dmodels/BM05B-SRSS-TB_LF__SN_.step
7.00 x 4.25 x 3.60 mm
