kmarx-kmarx-kmarx/Fluidcs-Hardware-V2/User KiCad Library/user-3dmodels/345-026-520-201 - EDAC Card Edge Connector.STEP

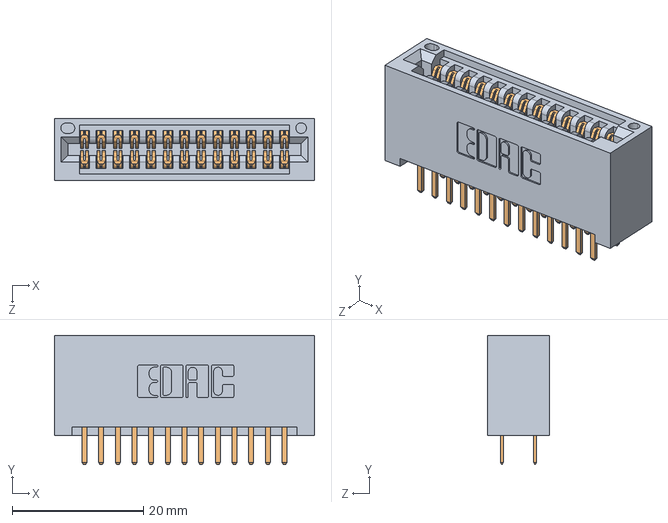
[picture p53: CAD file, 2023-08-08]
User KiCad Library/user-3dmodels/345-026-520-201 - EDAC Card Edge Connector.STEP
39.6 x 19.7 x 9.40 mm
345 Part_No Mounting Lugs
