kmarx-kmarx-kmarx/Fluidcs-Hardware-V2/User KiCad Library/user-3dmodels/SM14B-SRSS-TB_LF__SN_.stp

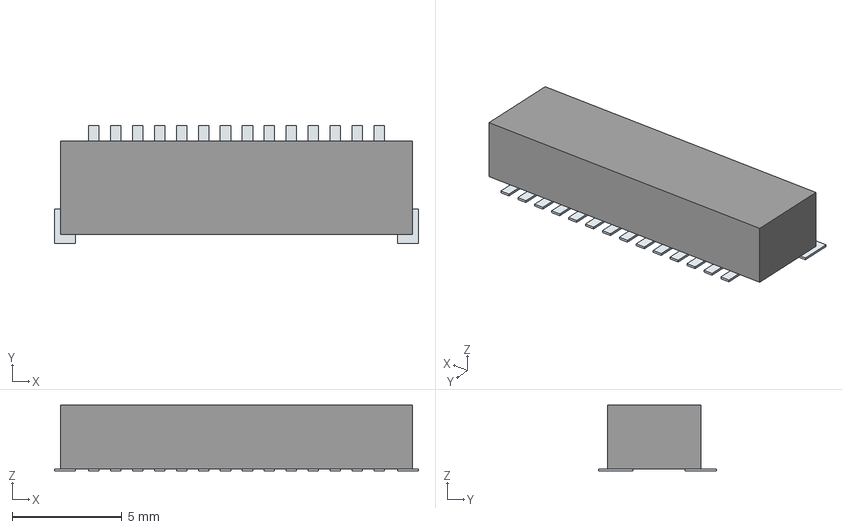
[picture p54: CAD file, 2023-08-08]
User KiCad Library/user-3dmodels/SM14B-SRSS-TB_LF__SN_.stp
16.6 x 5.37 x 3.00 mm
Pins
