kmarx-kmarx-kmarx/Fluidcs-Hardware-V2/User KiCad Library/user-3dmodels/SM03B-SRSS-TB.STEP

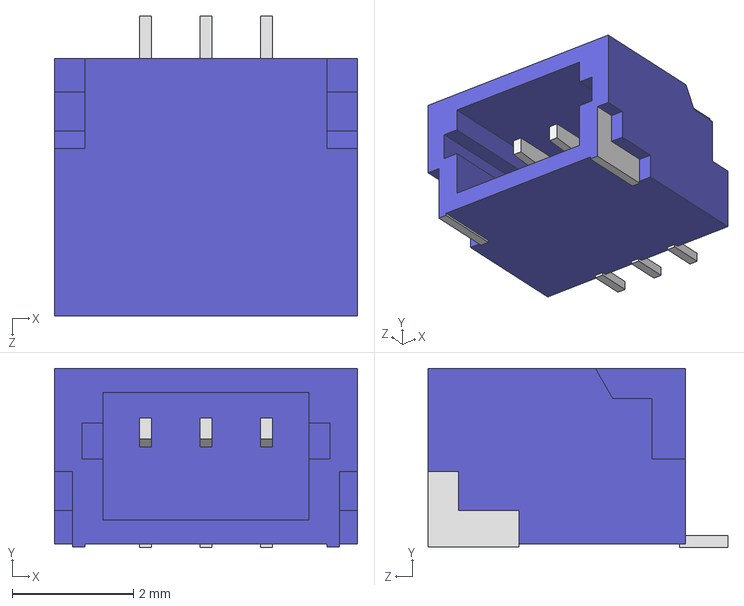
[picture p55: CAD file, 2023-08-08]
User KiCad Library/user-3dmodels/SM03B-SRSS-TB.STEP
5.00 x 2.96 x 4.95 mm
