kmarx-kmarx-kmarx/Fluidcs-Hardware-V2/(list of files, cad)

Other CAD files:
User KiCad Library/user-3dmodels/raspberry-pi-pico-r3-1/U3, W25Q16JVUXIQ, Serial NOR Flash 16 Mbit, Raspberry Pi Pico-R3.SLDPRT
User KiCad Library/user-3dmodels/PDS2-S5-S12-M.step
User KiCad Library/user-3dmodels/R-0904N-L-15KQ.step
User KiCad Library/user-3dmodels/R-0904N-L-20KQ-green.step
User KiCad Library/user-3dmodels/R-0904N-L-15KQ-green.step
User KiCad Library/user-3dmodels/BTS3410G.stp
User KiCad Library/user-3dmodels/R-0904N-L-20KQ-black.step
User KiCad Library/user-3dmodels/TMUX154EDGSR.stp
User KiCad Library/user-3dmodels/trustability-smt-rn-cad-model-centered.step
User KiCad Library/user-3dmodels/0533980671.step
User KiCad Library/user-3dmodels/0705430001.stp
User KiCad Library/user-3dmodels/1814650.stl
User KiCad Library/user-3dmodels/1814650.stp
User KiCad Library/user-3dmodels/1814728.stp
User KiCad Library/user-3dmodels/208658-1051.stp
User KiCad Library/user-3dmodels/2086581051.stp
User KiCad Library/user-3dmodels/282834-2.stp
User KiCad Library/user-3dmodels/450301014042_Download_STP_450301014042_rev1.stp
User KiCad Library/user-3dmodels/5040500491.stp
User KiCad Library/user-3dmodels/5040500691.stp
User KiCad Library/user-3dmodels/5040500891.stp
User KiCad Library/user-3dmodels/5040501291.stp
User KiCad Library/user-3dmodels/5600200420.stp
User KiCad Library/user-3dmodels/87832-1010.stp
User KiCad Library/user-3dmodels/AH1806-W-7.stl
User KiCad Library/user-3dmodels/DRV103U.stl
User KiCad Library/user-3dmodels/ISO7021FDR.stp
User KiCad Library/user-3dmodels/M50-3030442.stl
User KiCad Library/user-3dmodels/M50-3030442.stp
User KiCad Library/user-3dmodels/MCZ33996EKR2.stp
User KiCad Library/user-3dmodels/SM03B-SURS-TF_LF__SN_.stl
User KiCad Library/user-3dmodels/SM9541-100C-D-C-3-S.stl
User KiCad Library/user-3dmodels/STTH102AY.stl
User KiCad Library/user-3dmodels/m50-3030542_asm.igs
User KiCad Library/user-3dmodels/m50-3030542_asm.stp
User KiCad Library/user-3dmodels/m50-3031042_asm.stp
User KiCad Library/user-3dmodels/m50-3530442_asm.igs
User KiCad Library/user-3dmodels/m50-3530442_asm.stp
User KiCad Library/user-3dmodels/raspberry-pi-pico-r3-1/Raspberry Pi Pico-R3.x_b
