kmarx-kmarx-kmarx/Fluidcs-Hardware-V2/(commit log)

2023-08-08 added footprints and mounting holes, cleaned up some sheets
    [bubblesensors.kicad_sch, fluidics-v2.kicad_sch, manualctrl.kicad_sch, psu.kicad_sch, selectorvalves.kicad_sch, sensors.kicad_sch, syrpump.kicad_sch, uartshift.kicad_sch]
2023-08-08 fixed error in symbol
    [bubblesensors.kicad_sch, fluidics-v2.kicad_sch]
2023-08-08 updated text and schematic PDF
    [fluidics-v2.kicad_sch]
2023-08-08 added missing footprint
    [fluidics-v2.kicad_sch, manualctrl.kicad_sch]
2023-08-11 new version
    [bubblesensors.kicad_sch, fluidics-v2.kicad_sch, manualctrl.kicad_sch, sensors.kicad_sch, svalves.kicad_sch, syrpump.kicad_sch, uartshift.kicad_sch]
2023-08-14 started layout
    [bubblesensors.kicad_sch, fluidics-v2.kicad_pcb, fluidics-v2.kicad_sch, manualctrl.kicad_sch, psu.kicad_sch, selectorvalves.kicad_sch, sensors.kicad_sch, svalves.kicad_sch]
2023-08-16 added support for more I2C busses (3 + 1 address translator)
    [fluidics-v2.kicad_sch, i2c.kicad_sch]
2023-08-17 added pressure controllers and more flow sensors
    [bubblesensors.kicad_sch, fluidics-v2.kicad_sch, manualctrl.kicad_sch, pctrl.kicad_sch, selectorvalves.kicad_sch, sensors.kicad_sch, svalves.kicad_sch, syrpump.kicad_sch]
2023-08-30 added new connector for motor control daughter board. began layout
    [bubblesensors.kicad_sch, fluidics-v2.kicad_pcb, fluidics-v2.kicad_sch, i2c.kicad_sch, manualctrl.kicad_sch, pctrl.kicad_sch, psu.kicad_sch, selectorvalves.kicad_sch]
2023-08-30 done w/ layout
    [fluidics-v2.kicad_pcb, fluidics-v2.kicad_sch]
2023-09-05 finished schematic
    [fluidics-v2.kicad_pcb, fluidics-v2.kicad_sch]
2023-09-05 fixed 24v pour
    [fluidics-v2.kicad_pcb]
2023-11-15 added pullups/downs to spi for stability, rounded corners
    [bom.csv, designators.csv, fluidics-v2.kicad_pcb, fluidics-v2.kicad_sch, i2c.kicad_sch, manualctrl.kicad_sch, positions.csv, selectorvalves.kicad_sch]
2023-11-18 improved clearance for disc pump connector
    [fluidics-v2.kicad_pcb, positions.csv]
2023-11-24 compiled entire bom, incremental improvements to PCB
    [Fluidics Controller Complete BOM - Sheet1.csv, fluidics-v2.kicad_pcb]
2023-11-24 fixed board outline, added .step
    [fluidics-v2.kicad_pcb]
2023-11-28 fixed error on 3.3V line, added extra ground to fpc
    [fluidics-v2.kicad_pcb, fluidics-v2.kicad_sch]
