kmarx-kmarx-kmarx/Fluidcs-Hardware-V2/(notices)

Notices in the files:
fluidics-v2/fluidics-v2.kicad_pcb:
V 2.1 © Kevin Marx 9/6/2023
